daveho/computie/hardware/k30-SBC-dh/README.md

k30-SBC
=======

Status: Built & Tested

Latest: Rev.2

### About
A single board computer with DIP packaged chips.  The only programmable chip is the flash memory, which can
be written in-circuit using the Ardunio-based supervisor shield.

[Revision 2 Notes & Errata](revisions/k30-SBC-rev2-errata.txt)

[Revision 2 Schematic](revisions/k30-SBC-rev2.pdf)

[Revision 2 Gerbers](revisions/k30-SBC-rev2.zip)

k30-SBC board, which is 160mm x 100mm with a purple coloured solder mask and white pin headers, fully populated with all components, and with a CompactFlash card in the slot on the bottom left with a white and blue label that reads WD SiliconDrive II 8 GB PATA
k30-SBC board unpopulated, showing the purple solder mask and white silk screen labels
