daveho/computie/hardware/k30-SBC-dh/Bus.kicad_sch

## KiCad design hardware/k30-SBC-dh/Bus.kicad_sch (2025-05-20)

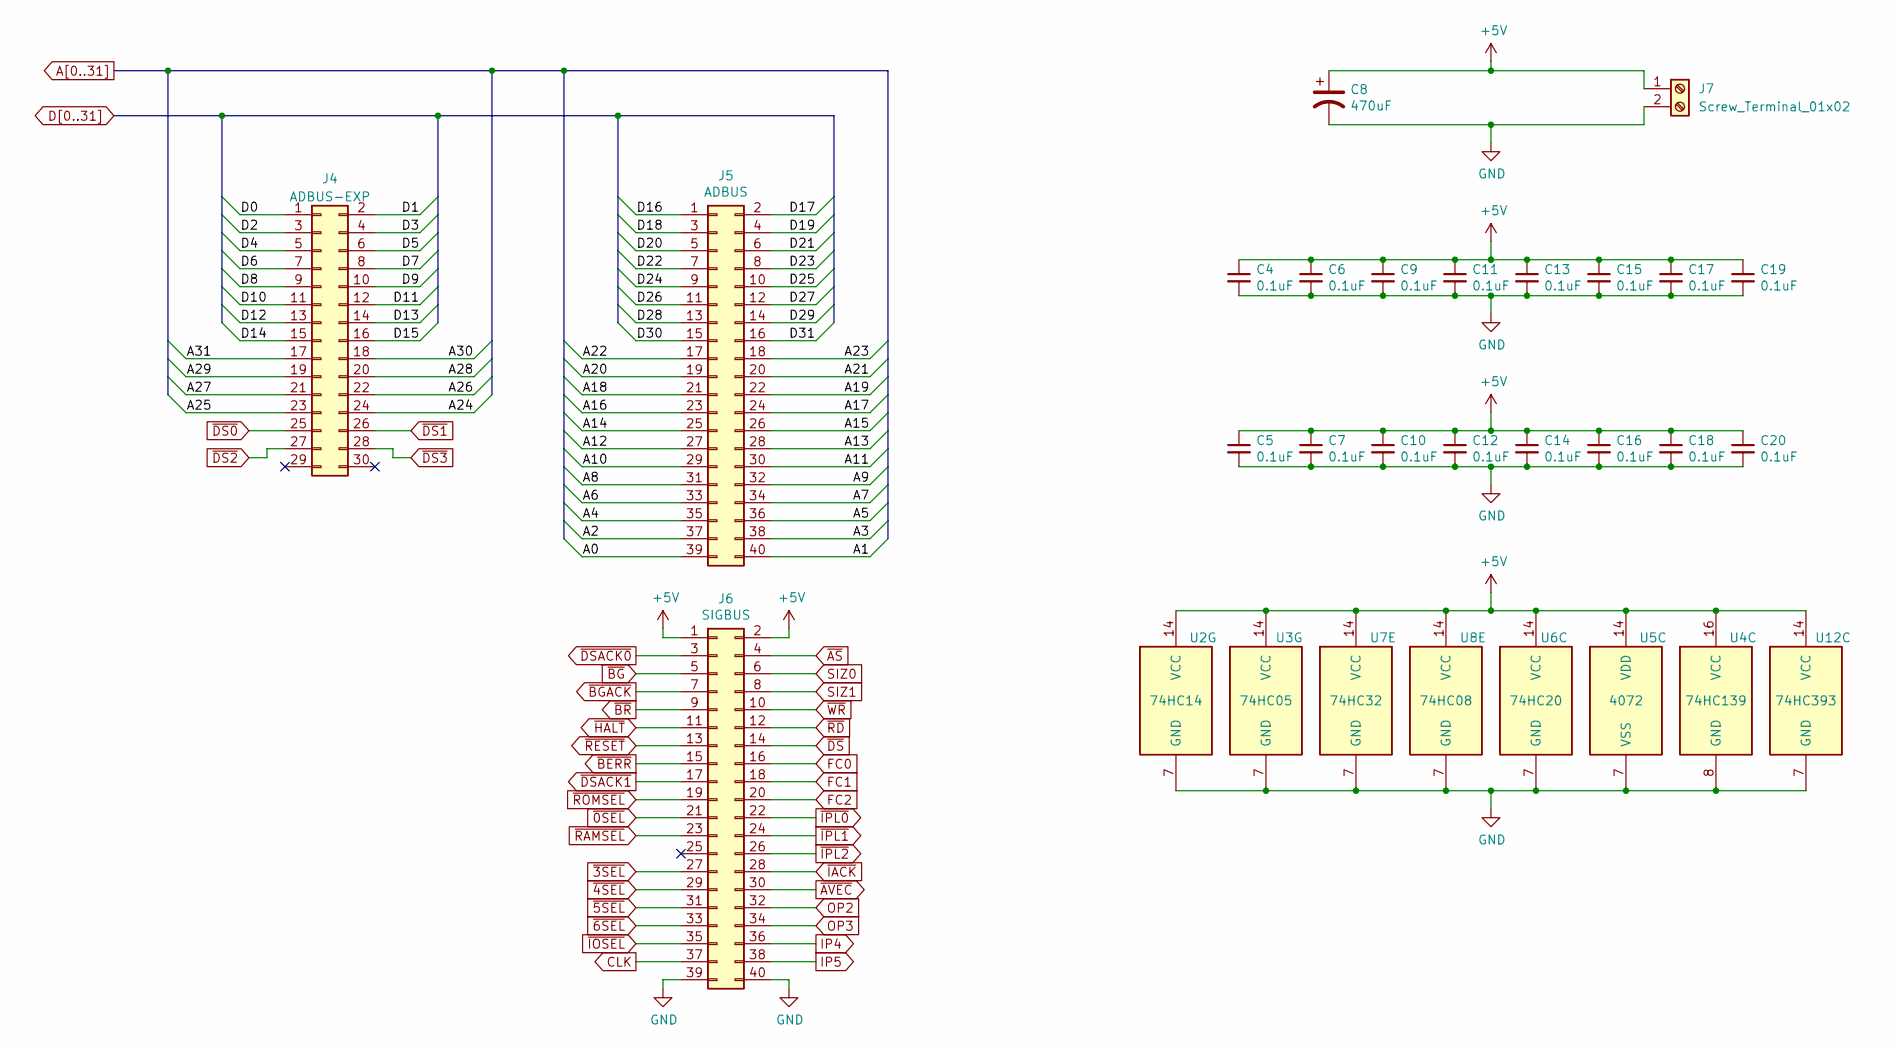
[picture p1: schematic Bus.kicad_sch]

Parts:
C4, C5, C6, C7, C9, C10, C11, C12, C13, C14, C15, C16, C17, C18, C19, C20: 0.1uF; C_Disc_D3.0mm_W2.0mm_P2.50mm
C8: 470uF; CP_Radial_D8.0mm_P5.00mm
J4: ADBUS-EXP; PinHeader_2x15_P2.54mm_Vertical
J5: ADBUS; PinHeader_2x20_P2.54mm_Vertical
J6: SIGBUS; PinHeader_2x20_P2.54mm_Vertical
J7: Screw_Terminal_01x02; TerminalBlock_CUI_TB007-508-02_1x02_P5.08mm_Horizontal
U2: 74HC14; TSSOP-14_4.4x5mm_P0.65mm
U3: 74HC05; TSSOP-14_4.4x5mm_P0.65mm
U4: 74HC139; TSSOP-16_4.4x5mm_P0.65mm
U5: 4072; TSSOP-14_4.4x5mm_P0.65mm
U6: 74HC20; TSSOP-14_4.4x5mm_P0.65mm
U7: 74HC32; TSSOP-14_4.4x5mm_P0.65mm
U8: 74HC08; TSSOP-14_4.4x5mm_P0.65mm
U12: 74HC393; TSSOP-14_4.4x5mm_P0.65mm

Connections:
+5V: C4.1, C5.1, C6.1, C7.1, C8.1, C9.1, C10.1, C11.1, C12.1, C13.1, C14.1, C15.1, C16.1, C17.1, C18.1, C19.1, C20.1, J6.1, J6.2, J7.1, U2.14 (VCC), U3.14 (VCC), U4.16 (VCC), U5.14 (VDD), U6.14 (VCC), U7.14 (VCC), U8.14 (VCC), U12.14 (VCC)
A0: J5.39
A1: J5.40
A2: J5.37
A3: J5.38
A4: J5.35
A5: J5.36
A6: J5.33
A7: J5.34
A8: J5.31
A9: J5.32
A10: J5.29
A11: J5.30
A12: J5.27
A13: J5.28
A14: J5.25
A15: J5.26
A16: J5.23
A17: J5.24
A18: J5.21
A19: J5.22
A20: J5.19
A21: J5.20
A22: J5.17
A23: J5.18
A24: J4.24
A25: J4.23
A26: J4.22
A27: J4.21
A28: J4.20
A29: J4.19
A30: J4.18
A31: J4.17
CLK: J6.37
D0: J4.1
D1: J4.2
D2: J4.3
D3: J4.4
D4: J4.5
D5: J4.6
D6: J4.7
D7: J4.8
D8: J4.9
D9: J4.10
D10: J4.11
D11: J4.12
D12: J4.13
D13: J4.14
D14: J4.15
D15: J4.16
D16: J5.1
D17: J5.2
D18: J5.3
D19: J5.4
D20: J5.5
D21: J5.6
D22: J5.7
D23: J5.8
D24: J5.9
D25: J5.10
D26: J5.11
D27: J5.12
D28: J5.13
D29: J5.14
D30: J5.15
D31: J5.16
FC0: J6.16
FC1: J6.18
FC2: J6.20
GND: C4.2, C5.2, C6.2, C7.2, C8.2, C9.2, C10.2, C11.2, C12.2, C13.2, C14.2, C15.2, C16.2, C17.2, C18.2, C19.2, C20.2, J6.39, J6.40, J7.2, U2.7 (GND), U3.7 (GND), U4.8 (GND), U5.7 (VSS), U6.7 (GND), U7.7 (GND), U8.7 (GND), U12.7 (GND)
IP4: J6.36
IP5: J6.38
OP2: J6.32
OP3: J6.34
SIZ0: J6.6
SIZ1: J6.8
~0SEL: J6.21
~3SEL: J6.27
~4SEL: J6.29
~5SEL: J6.31
~6SEL: J6.33
~AS: J6.4
~AVEC: J6.30
~BERR: J6.15
~BGACK: J6.7
~BG: J6.5
~BR: J6.9
~DS0: J4.25
~DS1: J4.26
~DS2: J4.27
~DS3: J4.28
~DSACK0: J6.3
~DSACK1: J6.17
~DS: J6.14
~HALT: J6.11
~IACK: J6.28
~IOSEL: J6.35
~IPL0: J6.22
~IPL1: J6.24
~IPL2: J6.26
~RAMSEL: J6.23
~RD: J6.12
~RESET: J6.13
~ROMSEL: J6.19
~WR: J6.10
