daveho/computie/hardware/k30-SBC-dh/IO.kicad_sch

## KiCad design hardware/k30-SBC-dh/IO.kicad_sch (2025-05-20)

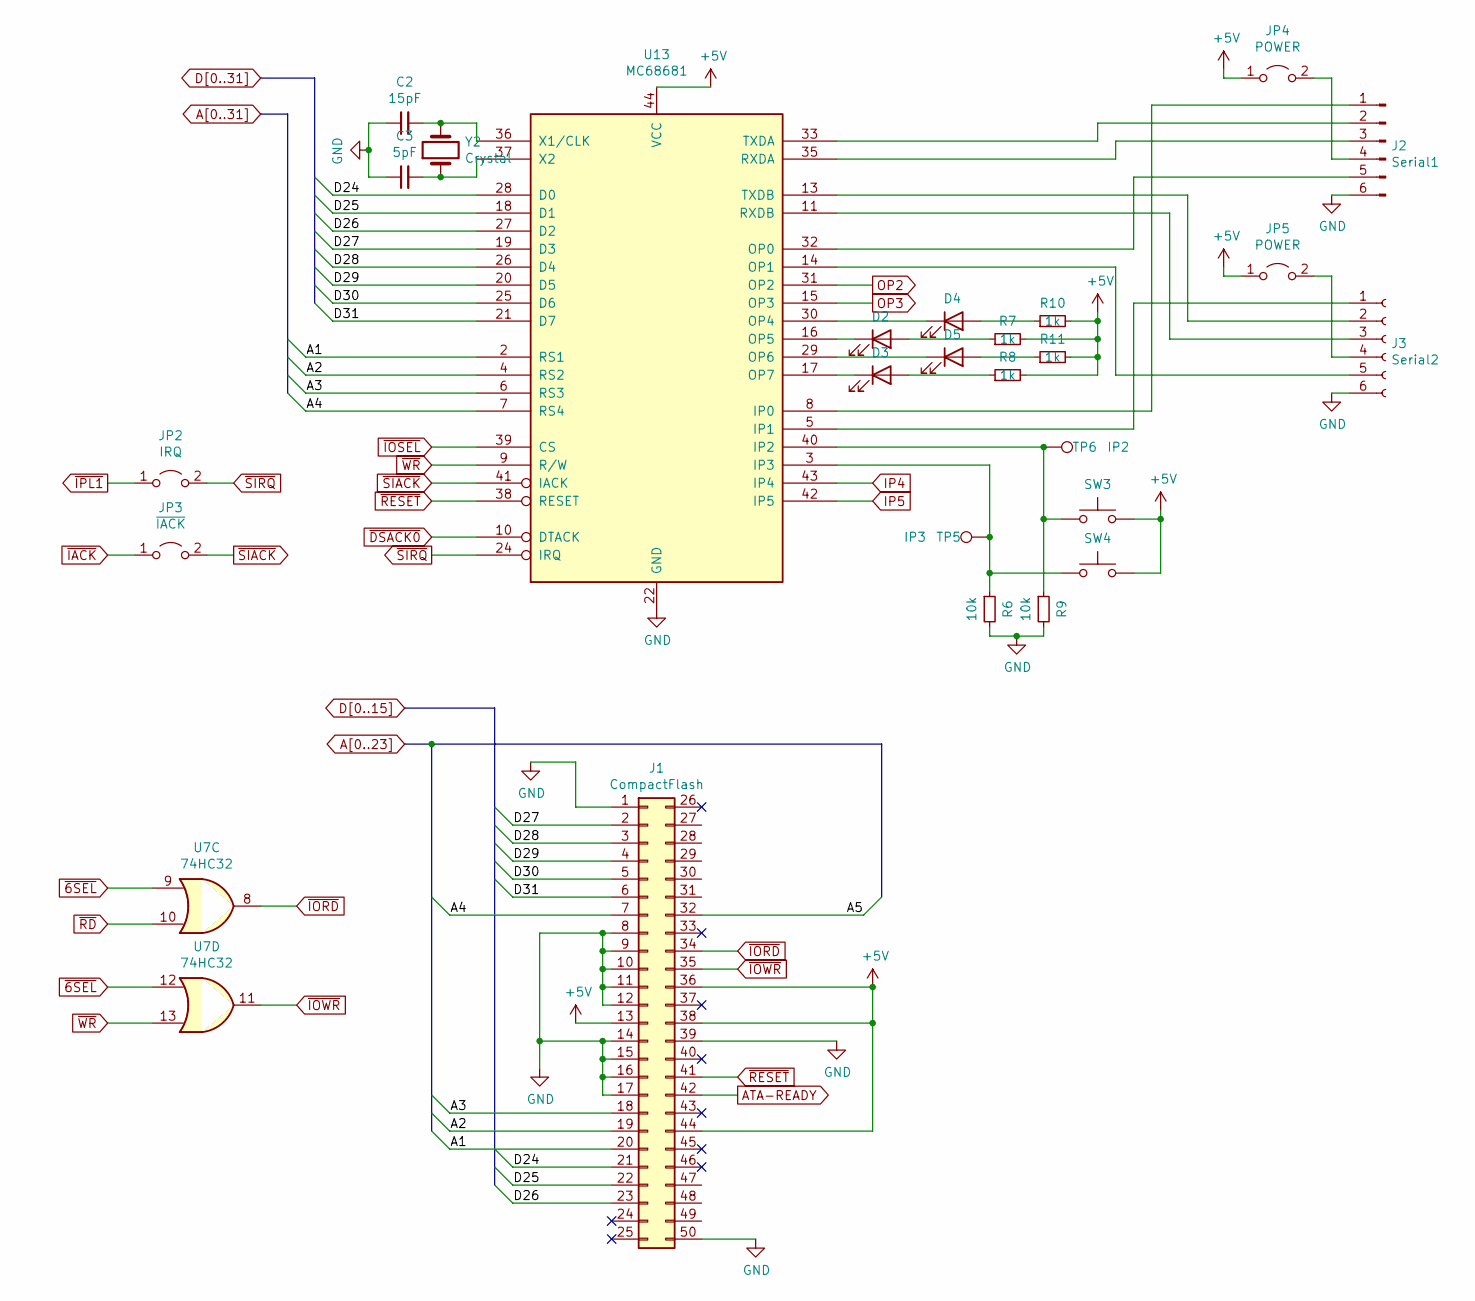
[picture p2: schematic IO.kicad_sch]

Parts:
C2: 15pF; C_Disc_D3.0mm_W2.0mm_P2.50mm
C3: 5pF; C_Disc_D3.0mm_W2.0mm_P2.50mm
D2: OP5; LED_D5.0mm
D3: OP7; LED_D5.0mm
D4: OP4; LED_D5.0mm
D5: OP6; LED_D5.0mm
J1: CompactFlash; CF-Card_3M_N7E50-Q516RB-40
J2: Serial1; PinHeader_1x06_P2.54mm_Vertical
J3: Serial2; PinHeader_1x06_P2.54mm_Vertical
JP2: IRQ; PinHeader_1x02_P2.54mm_Vertical
JP3: ~{IACK}; PinHeader_1x02_P2.54mm_Vertical
JP4, JP5: POWER; PinHeader_1x02_P2.54mm_Vertical
R6, R9: 10k; R_Axial_DIN0204_L3.6mm_D1.6mm_P5.08mm_Horizontal
R7, R8, R10, R11: 1k; R_Axial_DIN0204_L3.6mm_D1.6mm_P5.08mm_Horizontal
SW3: IP2; SW_PUSH_6mm
SW4: IP3; SW_PUSH_6mm
TP5: IP3; TestPoint_THTPad_2.0x2.0mm_Drill1.0mm
TP6: IP2; TestPoint_THTPad_2.0x2.0mm_Drill1.0mm
U7: 74HC32; TSSOP-14_4.4x5mm_P0.65mm
U13: MC68681; PLCC-44_THT-Socket
Y2: Crystal; Crystal_HC49-4H_Vertical

Connections:
+5V: J1.13, J1.36, J1.38, J1.44, JP4.1 (A), JP5.1 (A), R7.2, R8.2, R10.2, R11.2, SW3.2, SW4.2, U13.44 (VCC)
A1: J1.20, U13.2 (RS1)
A2: J1.19, U13.4 (RS2)
A3: J1.18, U13.6 (RS3)
A4: J1.7, U13.7 (RS4)
A5: J1.32
ATA-READY: J1.42
D24: J1.21, U13.28 (D0)
D25: J1.22, U13.18 (D1)
D26: J1.23, U13.27 (D2)
D27: J1.2, U13.19 (D3)
D28: J1.3, U13.26 (D4)
D29: J1.4, U13.20 (D5)
D30: J1.5, U13.25 (D6)
D31: J1.6, U13.21 (D7)
GND: C2.1, C3.1, J1.1, J1.8, J1.9, J1.10, J1.11, J1.12, J1.14, J1.15, J1.16, J1.17, J1.39, J1.50, J2.6, J3.6, R6.2, R9.2, U13.22 (GND)
IP4: U13.43 (IP4)
IP5: U13.42 (IP5)
unnamed: C2.2, U13.36 (X1/CLK), Y2.2
unnamed: C3.2, U13.37 (X2), Y2.1
unnamed: D2.1 (K), U13.16 (OP5)
unnamed: D2.2 (A), R7.1
unnamed: D3.1 (K), U13.17 (OP7)
unnamed: D3.2 (A), R8.1
unnamed: D4.1 (K), U13.30 (OP4)
unnamed: D4.2 (A), R10.1
unnamed: D5.1 (K), U13.29 (OP6)
unnamed: D5.2 (A), R11.1
unnamed: J2.1, U13.8 (IP0)
unnamed: J2.2, U13.33 (TXDA)
unnamed: J2.3, U13.35 (RXDA)
unnamed: J2.4, JP4.2 (B)
unnamed: J2.5, U13.32 (OP0)
unnamed: J3.1, U13.5 (IP1)
unnamed: J3.2, U13.13 (TXDB)
unnamed: J3.3, U13.11 (RXDB)
unnamed: J3.4, JP5.2 (B)
unnamed: J3.5, U13.14 (OP1)
unnamed: R6.1, SW4.1, TP5.1, U13.3 (IP3)
unnamed: R9.1, SW3.1, TP6.1, U13.40 (IP2)
OP2: U13.31 (OP2)
OP3: U13.15 (OP3)
~6SEL: U7.9, U7.12
~DSACK0: U13.10 (DTACK)
~IACK: JP3.1 (A)
~IORD: J1.34, U7.8
~IOSEL: U13.39 (CS)
~IOWR: J1.35, U7.11
~IPL1: JP2.1 (A)
~RD: U7.10
~RESET: J1.41, U13.38 (RESET)
~SIACK: JP3.2 (B), U13.41 (IACK)
~SIRQ: JP2.2 (B), U13.24 (IRQ)
~WR: U7.13, U13.9 (R/W)
