daveho/computie/hardware/k30-SBC-dh/Logic.kicad_sch

## KiCad design hardware/k30-SBC-dh/Logic.kicad_sch (2025-05-20)

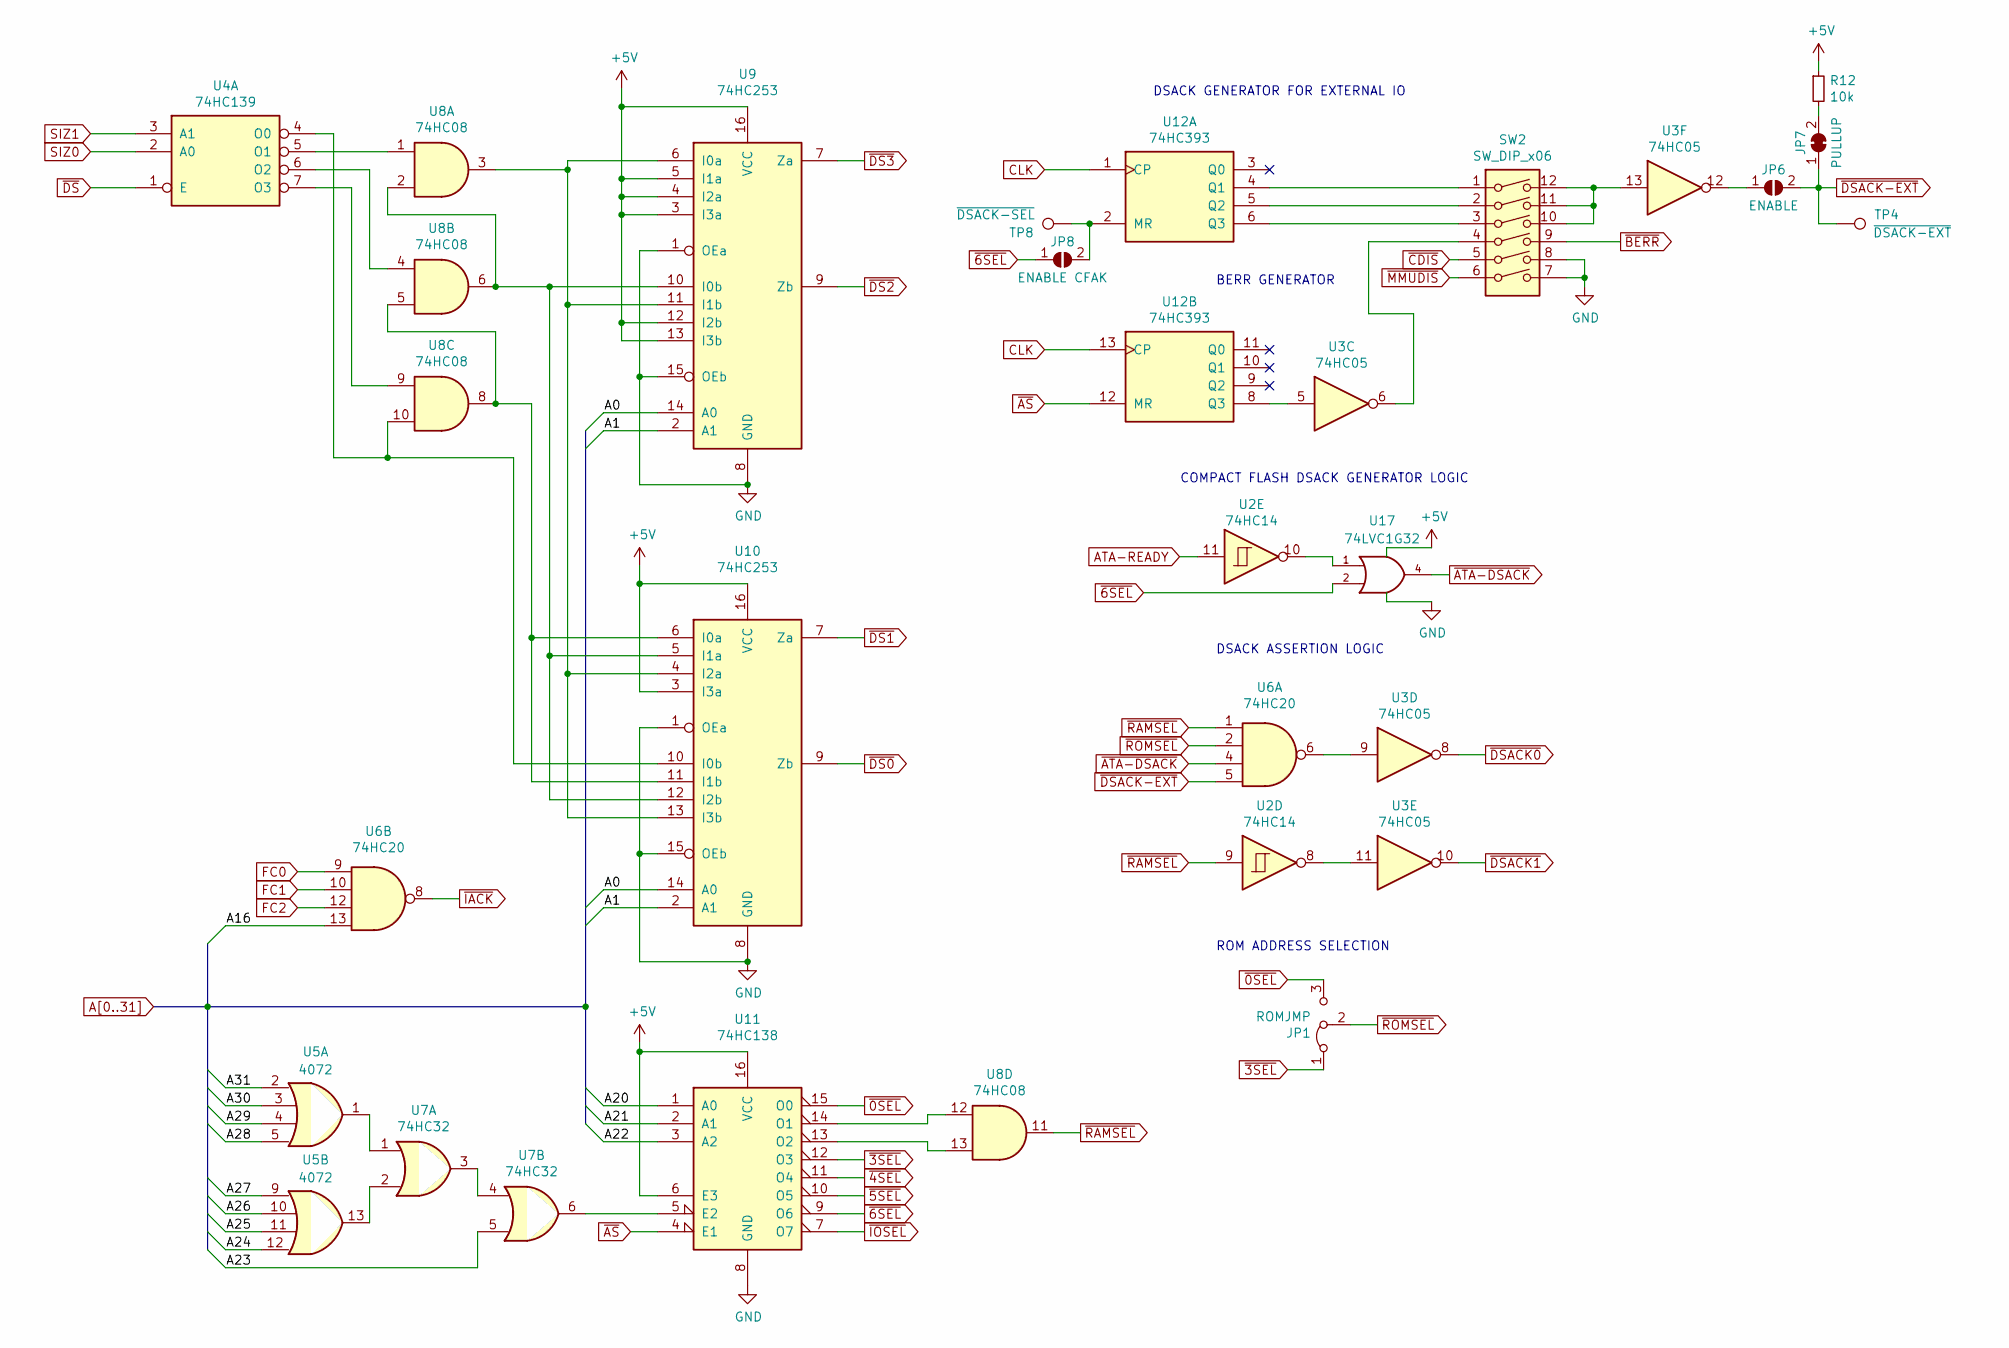
[picture p3: schematic Logic.kicad_sch]

Parts:
JP1: ROMJMP; PinHeader_1x03_P2.54mm_Vertical
JP6: ENABLE; SolderJumper-2_P1.3mm_Open_RoundedPad1.0x1.5mm
JP7: PULLUP; SolderJumper-2_P1.3mm_Bridged_RoundedPad1.0x1.5mm
JP8: ENABLE CFAK; SolderJumper-2_P1.3mm_Open_RoundedPad1.0x1.5mm
R12: 10k; R_Axial_DIN0204_L3.6mm_D1.6mm_P5.08mm_Horizontal
SW2: SW_DIP_x06; DIP-12_W7.62mm_LongPads
TP4: ~{DSACK-EXT}; TestPoint_THTPad_2.0x2.0mm_Drill1.0mm
TP8: ~{DSACK-SEL}; TestPoint_THTPad_2.0x2.0mm_Drill1.0mm
U2: 74HC14; TSSOP-14_4.4x5mm_P0.65mm
U3: 74HC05; TSSOP-14_4.4x5mm_P0.65mm
U4: 74HC139; TSSOP-16_4.4x5mm_P0.65mm
U5: 4072; TSSOP-14_4.4x5mm_P0.65mm
U6: 74HC20; TSSOP-14_4.4x5mm_P0.65mm
U7: 74HC32; TSSOP-14_4.4x5mm_P0.65mm
U8: 74HC08; TSSOP-14_4.4x5mm_P0.65mm
U9, U10: 74HC253; SSOP-16_5.3x6.2mm_P0.65mm
U11: 74HC138; TSSOP-16_4.4x5mm_P0.65mm
U12: 74HC393; TSSOP-14_4.4x5mm_P0.65mm
U17: 74LVC1G32; SOT-353_SC-70-5_Handsoldering

Connections:
+5V: R12.1, U9.3 (I3a), U9.4 (I2a), U9.5 (I1a), U9.12 (I2b), U9.13 (I3b), U9.16 (VCC), U10.3 (I3a), U10.16 (VCC), U11.6 (E3), U11.16 (VCC), U17.5 (VCC)
A0: U9.14 (A0), U10.14 (A0)
A1: U9.2 (A1), U10.2 (A1)
A16: U6.13
A20: U11.1 (A0)
A21: U11.2 (A1)
A22: U11.3 (A2)
A23: U7.5
A24: U5.12
A25: U5.11
A26: U5.10
A27: U5.9
A28: U5.5
A29: U5.4
A30: U5.3
A31: U5.2
ATA-READY: U2.11
CLK: U12.1 (CP), U12.13 (CP)
FC0: U6.9
FC1: U6.10
FC2: U6.12
GND: SW2.7, SW2.8, U9.1 (OEa), U9.8 (GND), U9.15 (OEb), U10.1 (OEa), U10.8 (GND), U10.15 (OEb), U11.8 (GND), U17.3 (GND)
unnamed: JP6.1 (A), U3.12
unnamed: JP7.2 (B), R12.2
unnamed: JP8.2 (B), TP8.1, U12.2 (MR)
unnamed: SW2.1, U12.4 (Q1)
unnamed: SW2.2, U12.5 (Q2)
unnamed: SW2.3, U12.6 (Q3)
unnamed: SW2.4, U3.6
unnamed: SW2.10, SW2.11, SW2.12, U3.13
unnamed: U2.8, U3.11
unnamed: U3.9, U6.6
unnamed: U4.5 (O1), U8.1
unnamed: U4.6 (O2), U8.4
unnamed: U4.7 (O3), U8.9
unnamed: U5.1, U7.1
unnamed: U5.13, U7.2
unnamed: U7.3, U7.4
unnamed: U4.4 (O0), U8.10, U10.10 (I0b)
unnamed: U8.5, U8.8, U10.6 (I0a), U10.11 (I1b)
unnamed: U8.2, U8.6, U9.10 (I0b), U10.5 (I1a), U10.12 (I2b)
unnamed: U8.3, U9.6 (I0a), U9.11 (I1b), U10.4 (I2a), U10.13 (I3b)
unnamed: U7.6, U11.5 (E2)
unnamed: U8.13, U11.13 (O2)
unnamed: U8.12, U11.14 (O1)
unnamed: U3.5, U12.8 (Q3)
unnamed: U2.10, U17.1
SIZ0: U4.2 (A0)
SIZ1: U4.3 (A1)
~0SEL: JP1.3 (B), U11.15 (O0)
~3SEL: JP1.1 (A), U11.12 (O3)
~4SEL: U11.11 (O4)
~5SEL: U11.10 (O5)
~6SEL: JP8.1 (A), U11.9 (O6), U17.2
~AS: U11.4 (E1), U12.12 (MR)
~ATA-DSACK: U6.4, U17.4
~BERR: SW2.9
~CDIS: SW2.5
~DS0: U10.9 (Zb)
~DS1: U10.7 (Za)
~DS2: U9.9 (Zb)
~DS3: U9.7 (Za)
~DSACK0: U3.8
~DSACK1: U3.10
~DSACK-EXT: JP6.2 (B), JP7.1 (A), TP4.1, U6.5
~DS: U4.1 (E)
~IACK: U6.8
~IOSEL: U11.7 (O7)
~MMUDIS: SW2.6
~RAMSEL: U2.9, U6.1, U8.11
~ROMSEL: JP1.2 (C), U6.2

Notes on the sheet:
DSACK ASSERTION LOGIC
DSACK GENERATOR FOR EXTERNAL IO
BERR GENERATOR
COMPACT FLASH DSACK GENERATOR LOGIC
ROM ADDRESS SELECTION
