daveho/computie/hardware/k30-SBC-dh/Memory.kicad_sch

## KiCad design hardware/k30-SBC-dh/Memory.kicad_sch (2025-05-20)

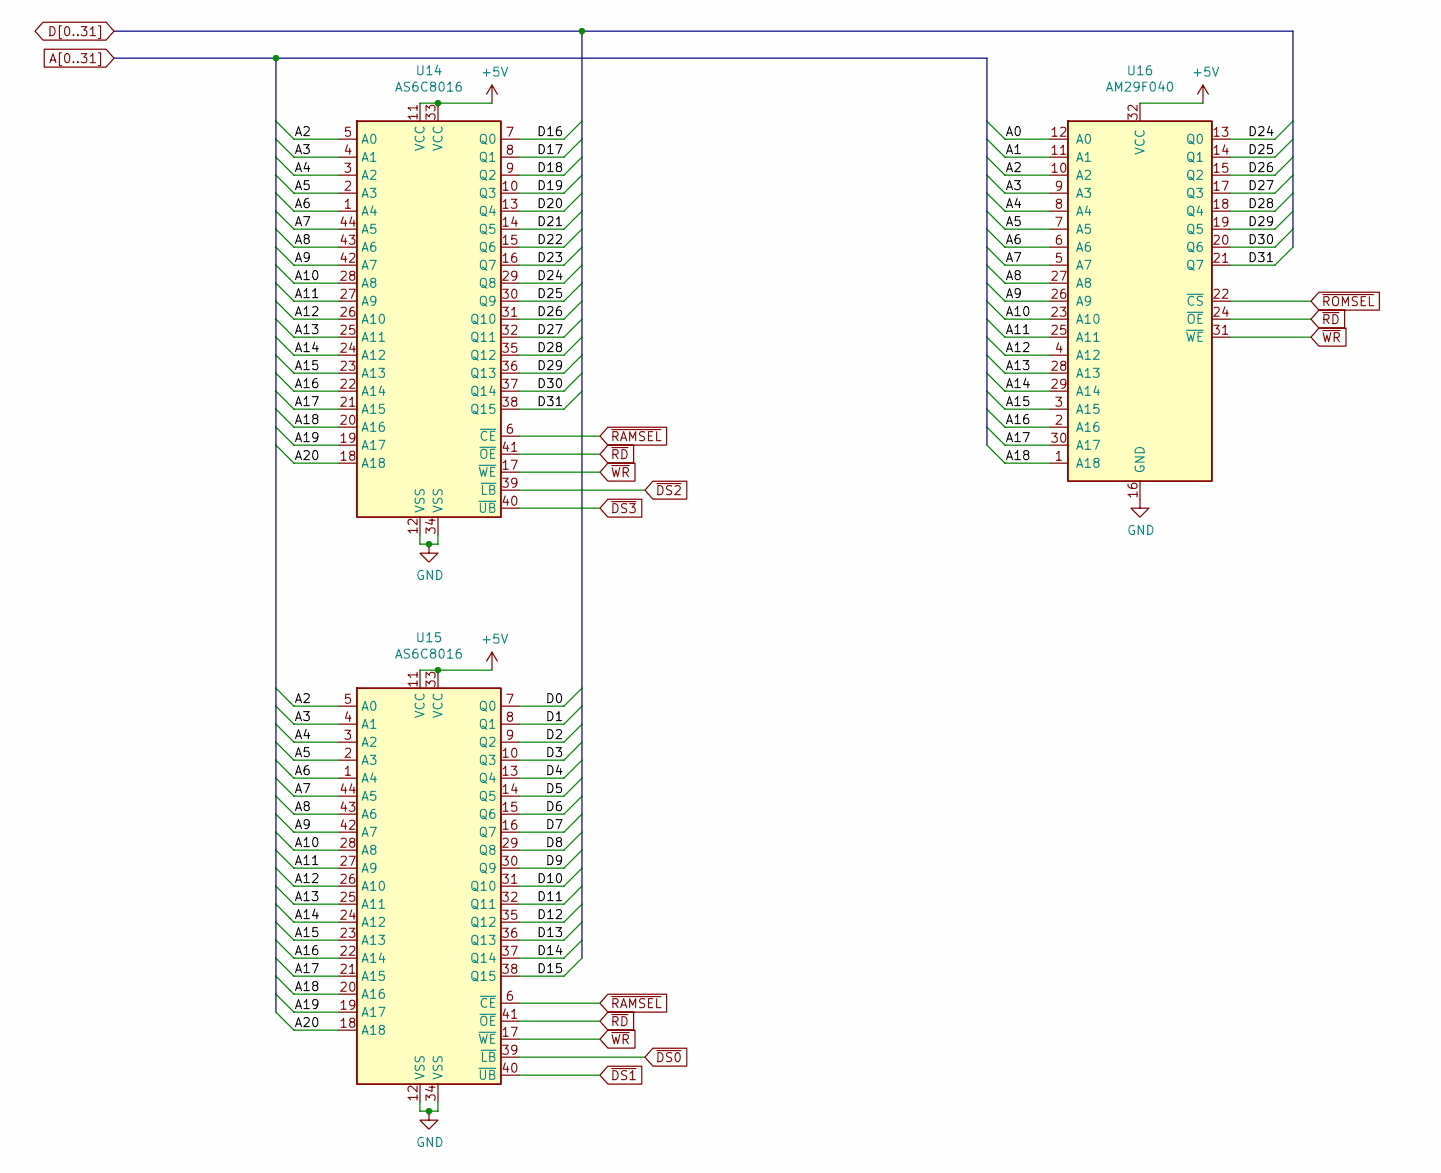
[picture p4: schematic Memory.kicad_sch]

Parts:
U14, U15: AS6C8016; TSOP-II-44_10.16x18.41mm_P0.8mm
U16: AM29F040; PLCC-32_THT-Socket

Connections:
+5V: U14.11 (VCC), U14.33 (VCC), U15.11 (VCC), U15.33 (VCC), U16.32 (VCC)
A0: U16.12 (A0)
A1: U16.11 (A1)
A2: U14.5 (A0), U15.5 (A0), U16.10 (A2)
A3: U14.4 (A1), U15.4 (A1), U16.9 (A3)
A4: U14.3 (A2), U15.3 (A2), U16.8 (A4)
A5: U14.2 (A3), U15.2 (A3), U16.7 (A5)
A6: U14.1 (A4), U15.1 (A4), U16.6 (A6)
A7: U14.44 (A5), U15.44 (A5), U16.5 (A7)
A8: U14.43 (A6), U15.43 (A6), U16.27 (A8)
A9: U14.42 (A7), U15.42 (A7), U16.26 (A9)
A10: U14.28 (A8), U15.28 (A8), U16.23 (A10)
A11: U14.27 (A9), U15.27 (A9), U16.25 (A11)
A12: U14.26 (A10), U15.26 (A10), U16.4 (A12)
A13: U14.25 (A11), U15.25 (A11), U16.28 (A13)
A14: U14.24 (A12), U15.24 (A12), U16.29 (A14)
A15: U14.23 (A13), U15.23 (A13), U16.3 (A15)
A16: U14.22 (A14), U15.22 (A14), U16.2 (A16)
A17: U14.21 (A15), U15.21 (A15), U16.30 (A17)
A18: U14.20 (A16), U15.20 (A16), U16.1 (A18)
A19: U14.19 (A17), U15.19 (A17)
A20: U14.18 (A18), U15.18 (A18)
D0: U15.7 (Q0)
D1: U15.8 (Q1)
D2: U15.9 (Q2)
D3: U15.10 (Q3)
D4: U15.13 (Q4)
D5: U15.14 (Q5)
D6: U15.15 (Q6)
D7: U15.16 (Q7)
D8: U15.29 (Q8)
D9: U15.30 (Q9)
D10: U15.31 (Q10)
D11: U15.32 (Q11)
D12: U15.35 (Q12)
D13: U15.36 (Q13)
D14: U15.37 (Q14)
D15: U15.38 (Q15)
D16: U14.7 (Q0)
D17: U14.8 (Q1)
D18: U14.9 (Q2)
D19: U14.10 (Q3)
D20: U14.13 (Q4)
D21: U14.14 (Q5)
D22: U14.15 (Q6)
D23: U14.16 (Q7)
D24: U14.29 (Q8), U16.13 (Q0)
D25: U14.30 (Q9), U16.14 (Q1)
D26: U14.31 (Q10), U16.15 (Q2)
D27: U14.32 (Q11), U16.17 (Q3)
D28: U14.35 (Q12), U16.18 (Q4)
D29: U14.36 (Q13), U16.19 (Q5)
D30: U14.37 (Q14), U16.20 (Q6)
D31: U14.38 (Q15), U16.21 (Q7)
GND: U14.12 (VSS), U14.34 (VSS), U15.12 (VSS), U15.34 (VSS), U16.16 (GND)
~DS0: U15.39 (~LB)
~DS1: U15.40 (~UB)
~DS2: U14.39 (~LB)
~DS3: U14.40 (~UB)
~RAMSEL: U14.6 (~CE), U15.6 (~CE)
~RD: U14.41 (~OE), U15.41 (~OE), U16.24 (~OE)
~ROMSEL: U16.22 (~CS)
~WR: U14.17 (~WE), U15.17 (~WE), U16.31 (~WE)
