daveho/computie/hardware/k30-SBC-dh/k30-SBC-dh.kicad_sch

## KiCad design hardware/k30-SBC-dh/k30-SBC-dh.kicad_sch (2025-05-20)

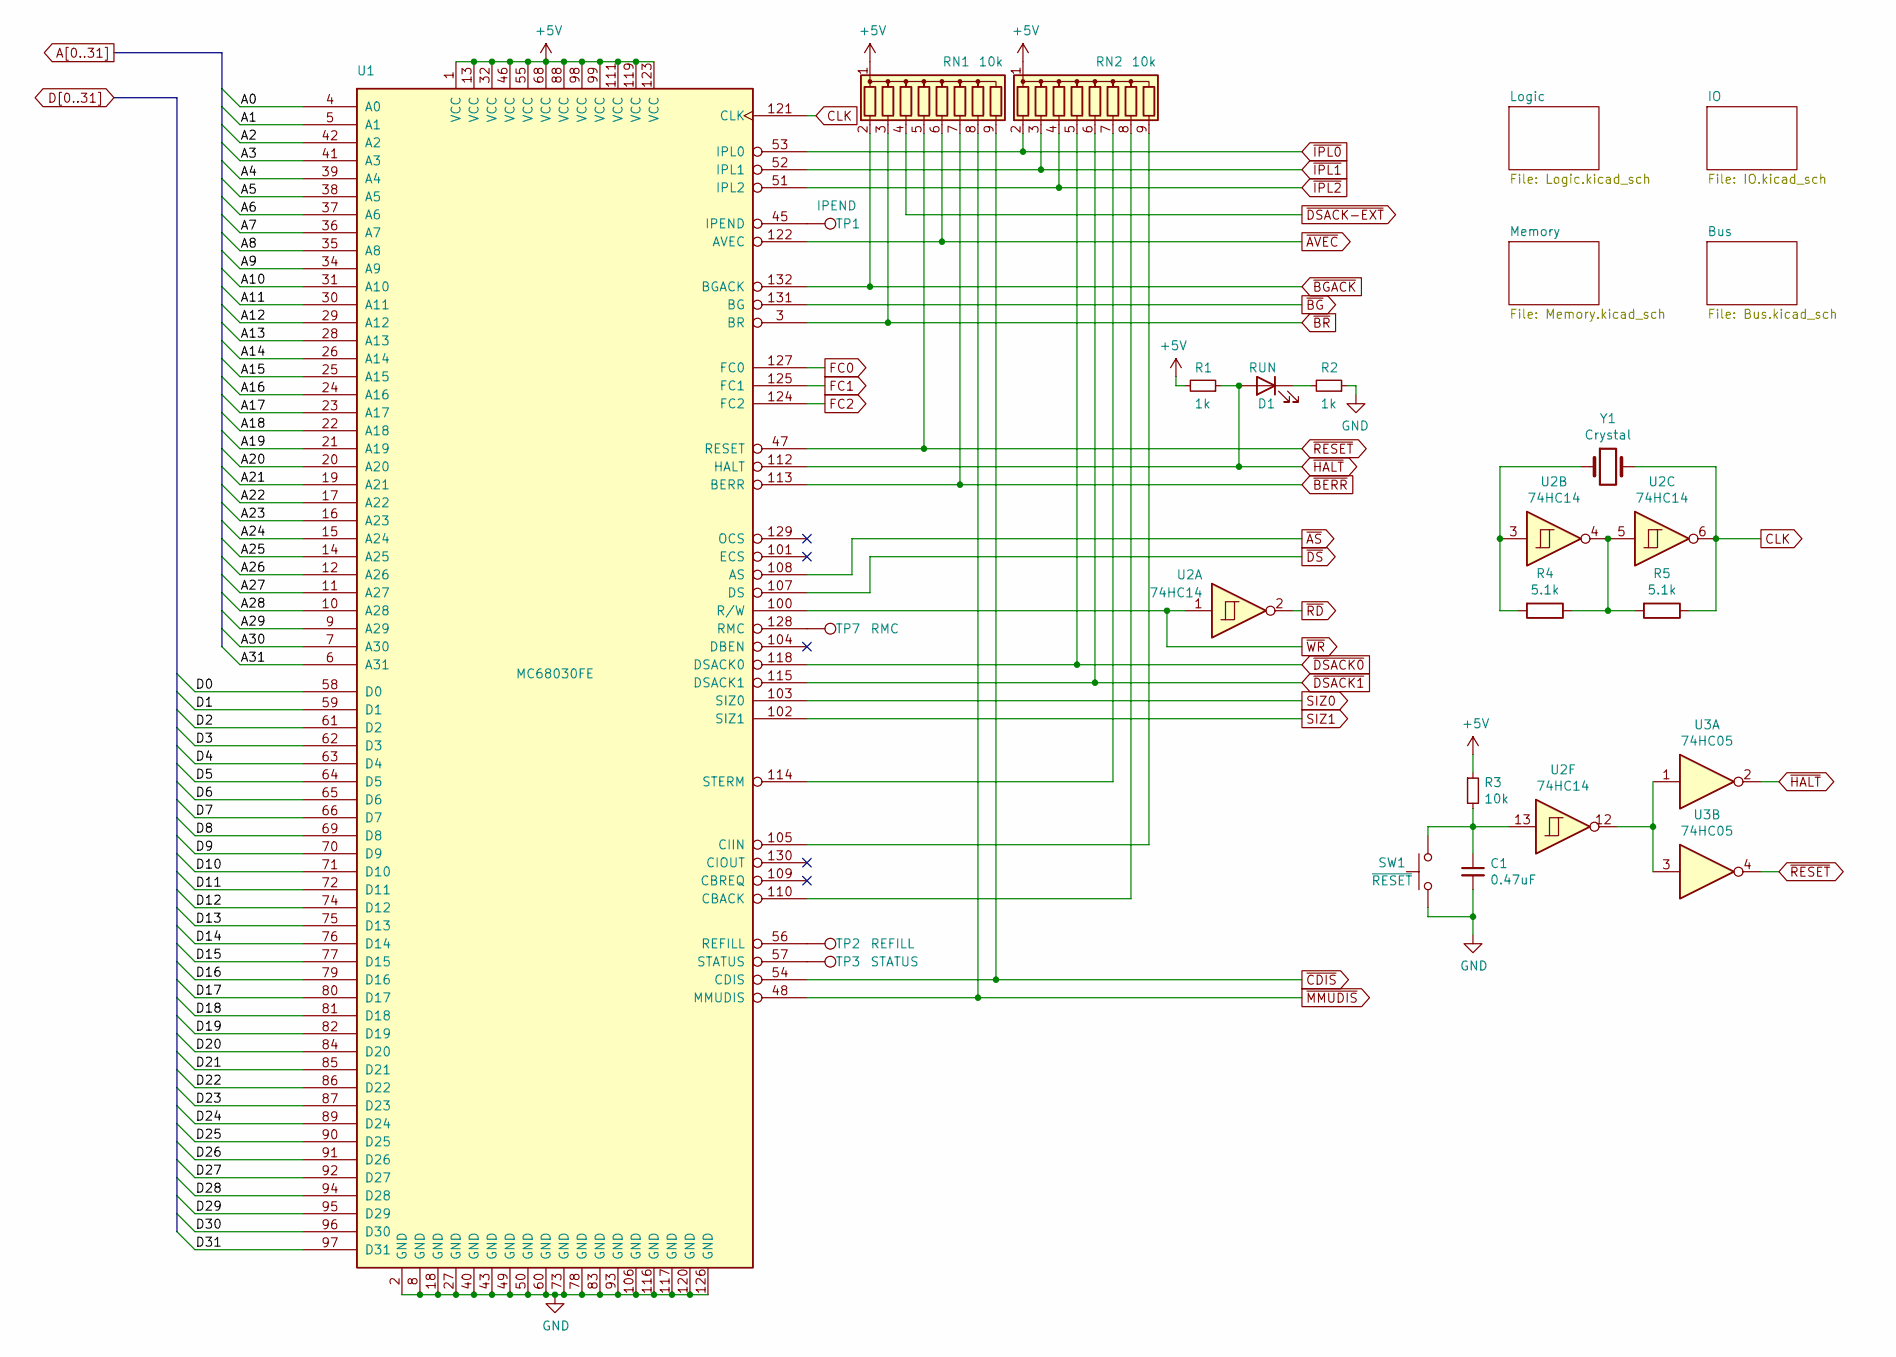
[picture p5: schematic k30-SBC-dh.kicad_sch]

Parts:
C1: 0.47uF; C_Disc_D3.0mm_W2.0mm_P2.50mm
D1: RUN; LED_D5.0mm
R1, R2: 1k; R_Axial_DIN0204_L3.6mm_D1.6mm_P5.08mm_Horizontal
R3: 10k; R_Axial_DIN0204_L3.6mm_D1.6mm_P5.08mm_Horizontal
R4, R5: 5.1k; R_Axial_DIN0204_L3.6mm_D1.6mm_P5.08mm_Horizontal
RN1, RN2: 10k; R_Array_SIP9
SW1: ~{RESET}; SW_PUSH_6mm
TP1: IPEND; TestPoint_THTPad_2.0x2.0mm_Drill1.0mm
TP2: REFILL; TestPoint_THTPad_2.0x2.0mm_Drill1.0mm
TP3: STATUS; TestPoint_THTPad_2.0x2.0mm_Drill1.0mm
TP7: RMC; TestPoint_THTPad_2.0x2.0mm_Drill1.0mm
U1: MC68030FE; PQFP-132_24x24mm_P0.635mm
U2: 74HC14; TSSOP-14_4.4x5mm_P0.65mm
U3: 74HC05; TSSOP-14_4.4x5mm_P0.65mm
Y1: Crystal; Crystal_HC49-4H_Vertical

Connections:
+5V: R1.2, R3.1, RN1.1 (common), RN2.1 (common), U1.1 (VCC), U1.13 (VCC), U1.32 (VCC), U1.46 (VCC), U1.55 (VCC), U1.68 (VCC), U1.88 (VCC), U1.98 (VCC), U1.99 (VCC), U1.111 (VCC), U1.119 (VCC), U1.123 (VCC)
A0: U1.4 (A0)
A1: U1.5 (A1)
A2: U1.42 (A2)
A3: U1.41 (A3)
A4: U1.39 (A4)
A5: U1.38 (A5)
A6: U1.37 (A6)
A7: U1.36 (A7)
A8: U1.35 (A8)
A9: U1.34 (A9)
A10: U1.31 (A10)
A11: U1.30 (A11)
A12: U1.29 (A12)
A13: U1.28 (A13)
A14: U1.26 (A14)
A15: U1.25 (A15)
A16: U1.24 (A16)
A17: U1.23 (A17)
A18: U1.22 (A18)
A19: U1.21 (A19)
A20: U1.20 (A20)
A21: U1.19 (A21)
A22: U1.17 (A22)
A23: U1.16 (A23)
A24: U1.15 (A24)
A25: U1.14 (A25)
A26: U1.12 (A26)
A27: U1.11 (A27)
A28: U1.10 (A28)
A29: U1.9 (A29)
A30: U1.7 (A30)
A31: U1.6 (A31)
CLK: R5.1, U1.121 (CLK), U2.6, Y1.2
D0: U1.58 (D0)
D1: U1.59 (D1)
D2: U1.61 (D2)
D3: U1.62 (D3)
D4: U1.63 (D4)
D5: U1.64 (D5)
D6: U1.65 (D6)
D7: U1.66 (D7)
D8: U1.69 (D8)
D9: U1.70 (D9)
D10: U1.71 (D10)
D11: U1.72 (D11)
D12: U1.74 (D12)
D13: U1.75 (D13)
D14: U1.76 (D14)
D15: U1.77 (D15)
D16: U1.79 (D16)
D17: U1.80 (D17)
D18: U1.81 (D18)
D19: U1.82 (D19)
D20: U1.84 (D20)
D21: U1.85 (D21)
D22: U1.86 (D22)
D23: U1.87 (D23)
D24: U1.89 (D24)
D25: U1.90 (D25)
D26: U1.91 (D26)
D27: U1.92 (D27)
D28: U1.94 (D28)
D29: U1.95 (D29)
D30: U1.96 (D30)
D31: U1.97 (D31)
FC0: U1.127 (FC0)
FC1: U1.125 (FC1)
FC2: U1.124 (FC2)
GND: C1.2, R2.1, SW1.1, U1.2 (GND), U1.8 (GND), U1.18 (GND), U1.27 (GND), U1.40 (GND), U1.43 (GND), U1.49 (GND), U1.50 (GND), U1.60 (GND), U1.73 (GND), U1.78 (GND), U1.83 (GND), U1.93 (GND), U1.106 (GND), U1.116 (GND), U1.117 (GND), U1.120 (GND), U1.126 (GND)
unnamed: C1.1, R3.2, SW1.2, U2.13
unnamed: D1.1 (K), R2.2
unnamed: R4.1, R5.2, U2.4, U2.5
unnamed: R4.2, U2.3, Y1.1
unnamed: RN2.7 (R6), U1.114 (STERM)
unnamed: RN2.8 (R7), U1.110 (CBACK)
unnamed: RN2.9 (R8), U1.105 (CIIN)
unnamed: TP1.1, U1.45 (IPEND)
unnamed: TP2.1, U1.56 (REFILL)
unnamed: TP3.1, U1.57 (STATUS)
unnamed: TP7.1, U1.128 (RMC)
unnamed: U2.12, U3.1, U3.3
SIZ0: U1.103 (SIZ0)
SIZ1: U1.102 (SIZ1)
~AS: U1.108 (AS)
~AVEC: RN1.6 (R5), U1.122 (AVEC)
~BERR: RN1.7 (R6), U1.113 (BERR)
~BGACK: RN1.2 (R1), U1.132 (BGACK)
~BG: U1.131 (BG)
~BR: RN1.3 (R2), U1.3 (BR)
~CDIS: RN1.9 (R8), U1.54 (CDIS)
~DSACK0: RN2.5 (R4), U1.118 (DSACK0)
~DSACK1: RN2.6 (R5), U1.115 (DSACK1)
~DSACK-EXT: RN1.4 (R3)
~DS: U1.107 (DS)
~HALT: D1.2 (A), R1.1, U1.112 (HALT), U3.2
~IPL0: RN2.2 (R1), U1.53 (IPL0)
~IPL1: RN2.3 (R2), U1.52 (IPL1)
~IPL2: RN2.4 (R3), U1.51 (IPL2)
~MMUDIS: RN1.8 (R7), U1.48 (MMUDIS)
~RD: U2.2
~RESET: RN1.5 (R4), U1.47 (RESET), U3.4
~WR: U1.100 (R/W), U2.1
