daveho/computie/(commit log)

2025-05-20 creating new copy of k30-SBC
    The only change I'm planning to make is using a terminal
    block for power rather than 0.1" header pins.
    [Bus.kicad_sch, IO.kicad_sch, Logic.kicad_sch, Memory.kicad_sch, k30-SBC-dh.kicad_sch]
2025-05-20 use 5.08mm 1x2 screw terminal for power
    These are good for 6A.
    Noted on the silkscreen that this is a modified version
    of the PCB.
    [Bus.kicad_sch, IO.kicad_sch, Logic.kicad_sch, Memory.kicad_sch, k30-SBC-dh.kicad_sch]
2025-05-20 generated gerber files
    [k30-SBC-dh-B_Cu.gbl, k30-SBC-dh-B_Mask.gbs, k30-SBC-dh-Edge_Cuts.gm1, k30-SBC-dh-F_Cu.gtl, k30-SBC-dh-F_Mask.gts, k30-SBC-dh-F_Silkscreen.gto]
2025-05-20 ignore gerber zipfile
2025-05-20 generate BOM
    [k30-SBC-dh.csv]
